ABHISHEK22415/f722-2020-fc/hardware/kicad/f722-2020-fc.kicad_sch

## KiCad design hardware/kicad/f722-2020-fc.kicad_sch (2026-10-28)

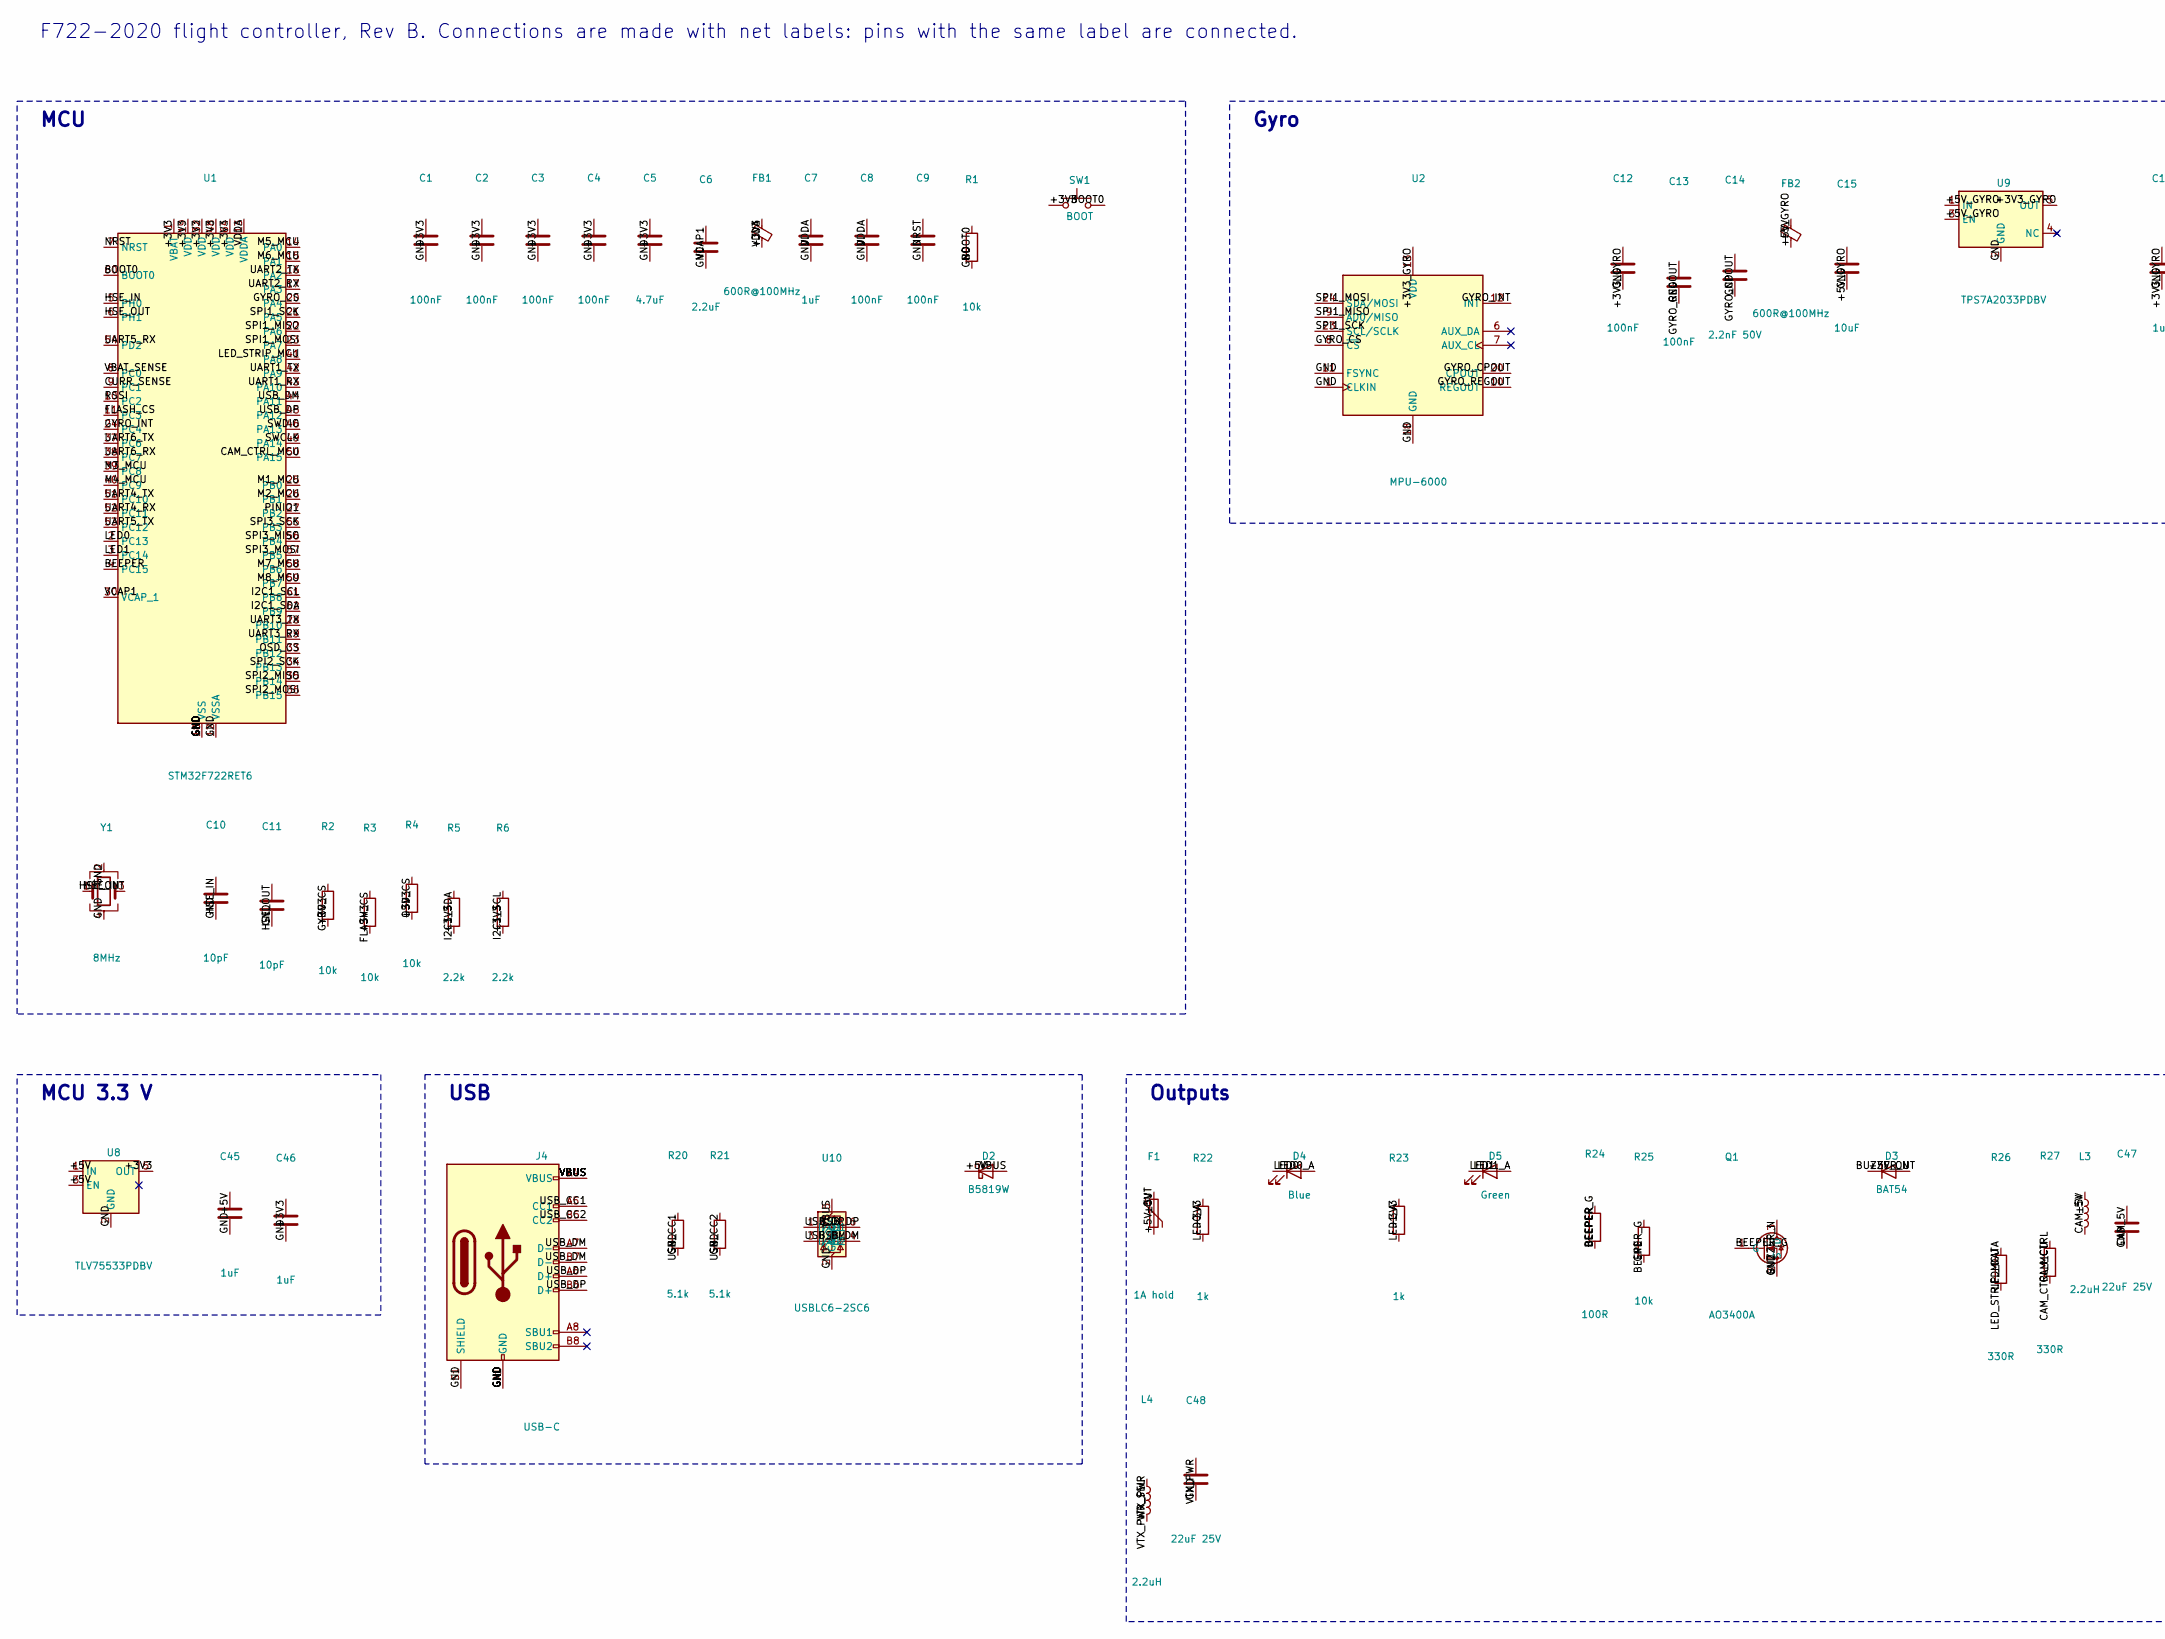
[picture p7: schematic f722-2020-fc.kicad_sch, part in row 1, column 1]

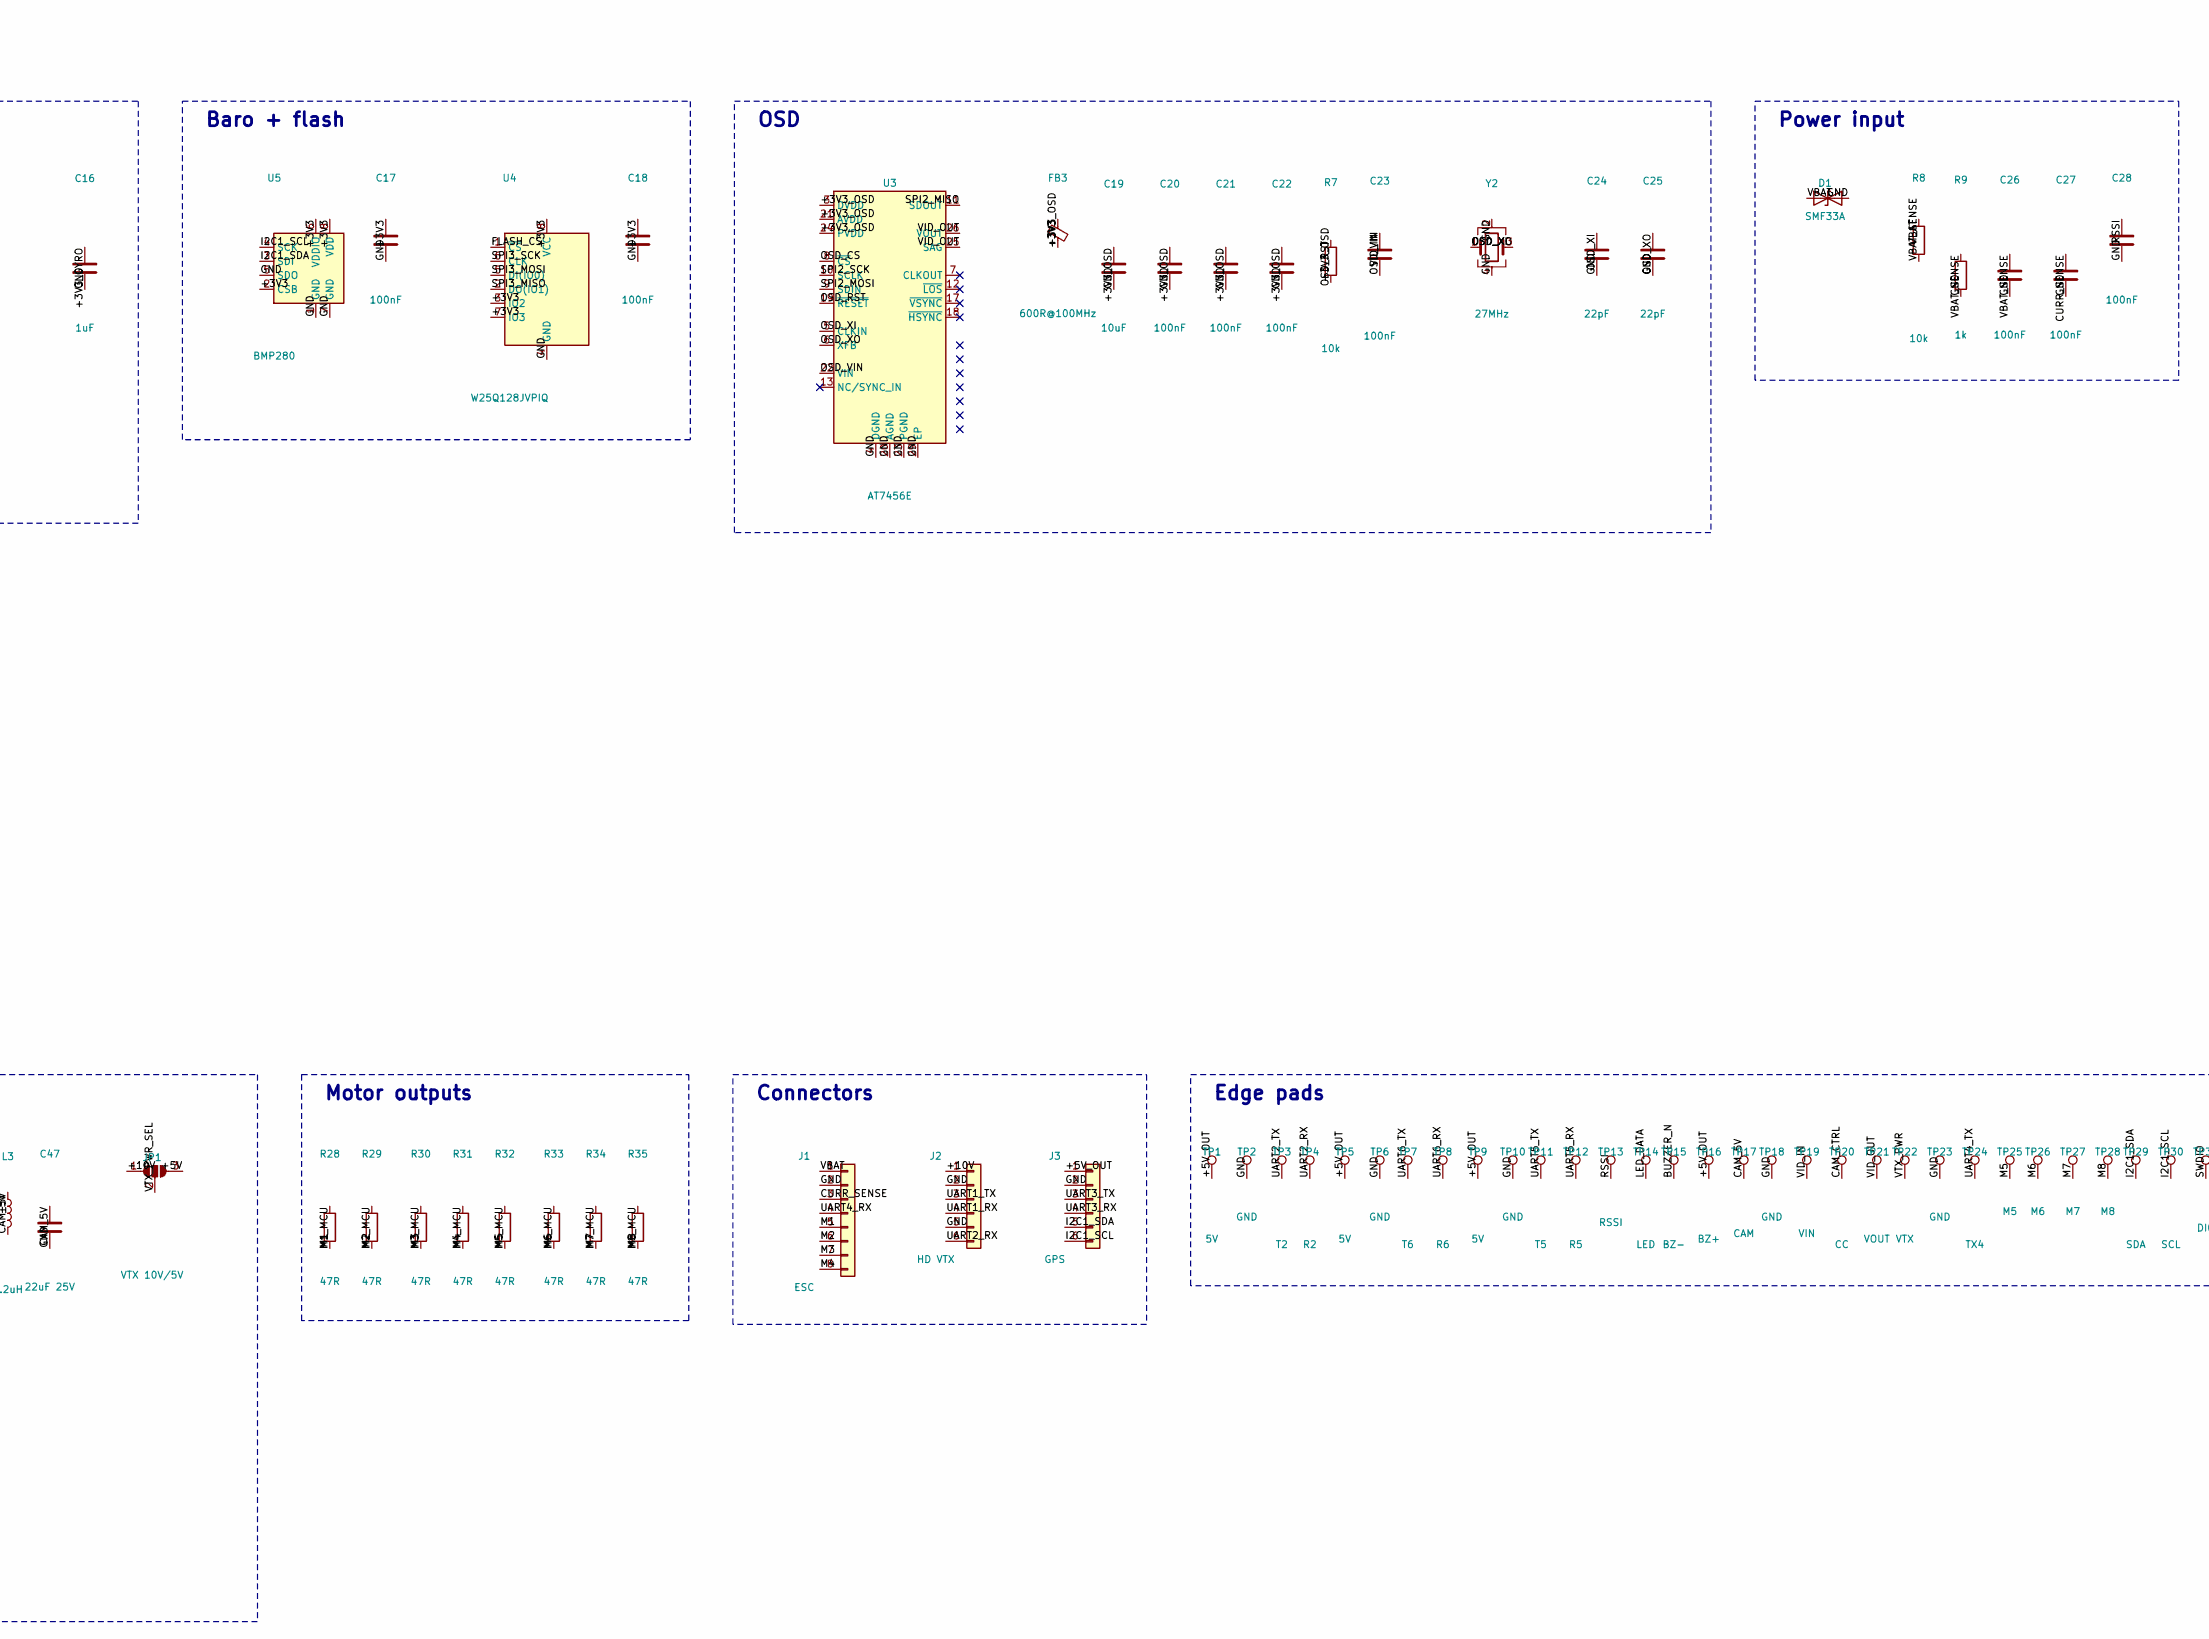
[picture p8: schematic f722-2020-fc.kicad_sch, part in row 1, column 2]

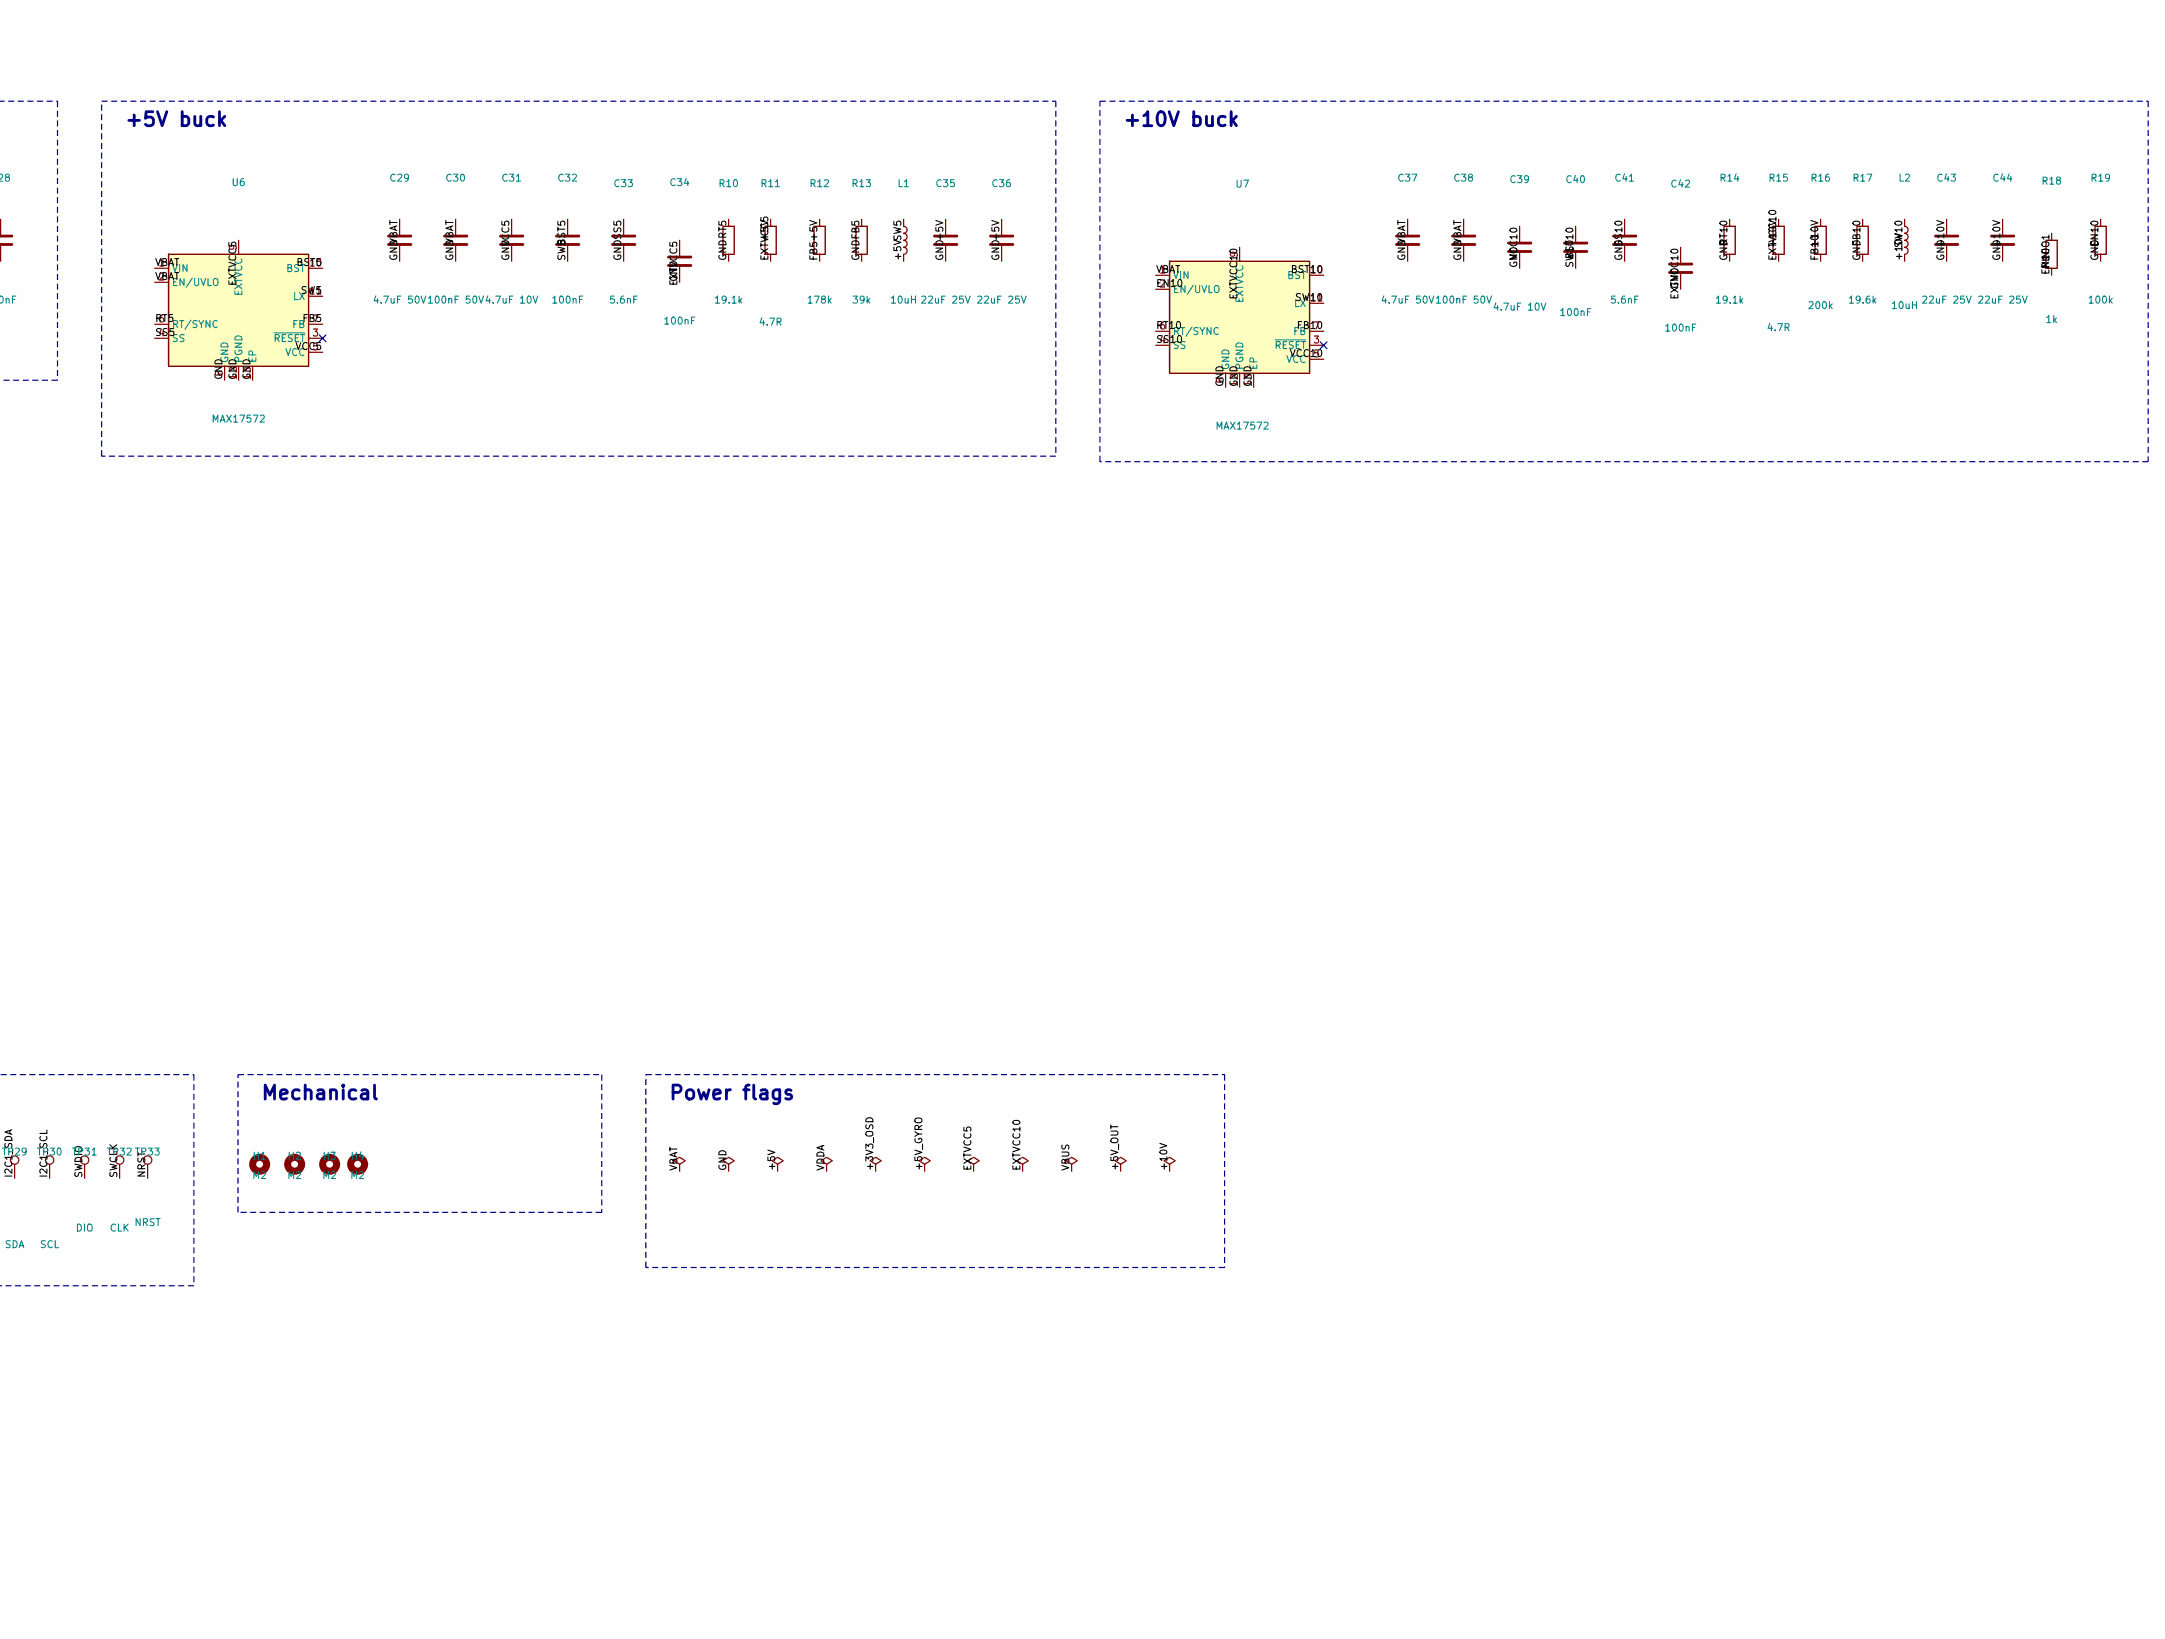
[picture p9: schematic f722-2020-fc.kicad_sch, part in row 1, column 3]

Parts:
C1, C2, C3, C4, C8, C9, C12, C13, C17, C18, C20, C21, C22, C23, C26, C27, C28, C32, C34, C40, C42: 100nF; C_0201_0603Metric
C5: 4.7uF; C_0603_1608Metric
C6: 2.2uF; C_0603_1608Metric
C7, C16, C45, C46: 1uF; C_0402_1005Metric
C10, C11: 10pF; C_0201_0603Metric
C14: 2.2nF 50V; C_0402_1005Metric
C15, C19: 10uF; C_0603_1608Metric
C24, C25: 22pF; C_0201_0603Metric
C29, C37: 4.7uF 50V; C_1206_3216Metric
C30, C38: 100nF 50V; C_0402_1005Metric
C31, C39: 4.7uF 10V; C_0603_1608Metric
C33, C41: 5.6nF; C_0201_0603Metric
C35, C36, C43, C44, C47, C48: 22uF 25V; C_0805_2012Metric
D1: SMF33A; D_SOD-123F
D2: B5819W; D_SOD-123
D3: BAT54; D_SOD-323
D4: Blue; LED_0603_1608Metric
D5: Green; LED_0603_1608Metric
F1: 1A hold; Fuse_1206_3216Metric
FB1, FB2, FB3: 600R@100MHz; L_0201_0603Metric
H1, H2, H3, H4: M2; MountingHole_2.2mm_M2
J1: ESC; JST_SH_BM08B-SRSS-TB_1x08-1MP_P1.00mm_Vertical
J2: HD VTX; JST_SH_BM06B-SRSS-TB_1x06-1MP_P1.00mm_Vertical
J3: GPS; JST_SH_BM06B-SRSS-TB_1x06-1MP_P1.00mm_Vertical
J4: USB-C; USB_C_Receptacle_HRO_TYPE-C-31-M-12
JP1: VTX 10V/5V; SolderJumper-3_P1.3mm_Open_RoundedPad1.0x1.5mm
L1, L2: 10uH; L_Taiyo-Yuden_MD-3030
L3, L4: 2.2uH; L_0805_2012Metric
Q1: AO3400A; SOT-23
R1, R2, R3, R4, R7, R25: 10k; R_0201_0603Metric
R5, R6: 2.2k; R_0201_0603Metric
R8: 10k; R_0402_1005Metric
R9, R18, R22, R23: 1k; R_0201_0603Metric
R10, R14: 19.1k; R_0201_0603Metric
R11, R15: 4.7R; R_0201_0603Metric
R12: 178k; R_0201_0603Metric
R13: 39k; R_0201_0603Metric
R16: 200k; R_0201_0603Metric
R17: 19.6k; R_0201_0603Metric
R19: 100k; R_0201_0603Metric
R20, R21: 5.1k; R_0201_0603Metric
R24: 100R; R_0201_0603Metric
R26, R27: 330R; R_0201_0603Metric
R28, R29, R30, R31, R32, R33, R34, R35: 47R; R_0201_0603Metric
SW1: BOOT; SW_SPST_B3U-1000P
TP1, TP5, TP9: 5V; TestPoint_Pad_1.5x1.5mm
TP2, TP6, TP10, TP18, TP23: GND; TestPoint_Pad_1.5x1.5mm
TP3: T2; TestPoint_Pad_1.5x1.5mm
TP4: R2; TestPoint_Pad_1.5x1.5mm
TP7: T6; TestPoint_Pad_1.5x1.5mm
TP8: R6; TestPoint_Pad_1.5x1.5mm
TP11: T5; TestPoint_Pad_1.5x1.5mm
TP12: R5; TestPoint_Pad_1.5x1.5mm
TP13: RSSI; TestPoint_Pad_1.5x1.5mm
TP14: LED; TestPoint_Pad_1.5x1.5mm
TP15: BZ-; TestPoint_Pad_1.5x1.5mm
TP16: BZ+; TestPoint_Pad_1.5x1.5mm
TP17: CAM; TestPoint_Pad_1.5x1.5mm
TP19: VIN; TestPoint_Pad_1.5x1.5mm
TP20: CC; TestPoint_Pad_1.5x1.5mm
TP21: VOUT; TestPoint_Pad_1.5x1.5mm
TP22: VTX; TestPoint_Pad_1.5x1.5mm
TP24: TX4; TestPoint_Pad_1.5x1.5mm
TP25: M5; TestPoint_Pad_1.5x1.5mm
TP26: M6; TestPoint_Pad_1.5x1.5mm
TP27: M7; TestPoint_Pad_1.5x1.5mm
TP28: M8; TestPoint_Pad_1.5x1.5mm
TP29: SDA; TestPoint_Pad_1.5x1.5mm
TP30: SCL; TestPoint_Pad_1.5x1.5mm
TP31: DIO; TestPoint_Pad_1.5x1.5mm
TP32: CLK; TestPoint_Pad_1.5x1.5mm
TP33: NRST; TestPoint_Pad_1.5x1.5mm
U1: STM32F722RET6; LQFP-64_10x10mm_P0.5mm
U2: MPU-6000; InvenSense_QFN-24_4x4mm_P0.5mm
U3: AT7456E; TSSOP-28-1EP_4.4x9.7mm_P0.65mm
U4: W25Q128JVPIQ; WSON-8-1EP_6x5mm_P1.27mm_EP3.4x4mm
U5: BMP280; Bosch_LGA-8_2x2.5mm_P0.65mm_ClockwisePinNumbering
U6, U7: MAX17572; DFN-12-1EP_3x3mm_P0.5mm_EP2.05x2.86mm
U8: TLV75533PDBV; SOT-23-5
U9: TPS7A2033PDBV; SOT-23-5
U10: USBLC6-2SC6; SOT-23-6
Y1: 8MHz; Crystal_SMD_3225-4Pin_3.2x2.5mm
Y2: 27MHz; Crystal_SMD_3225-4Pin_3.2x2.5mm

Connections:
+3V3: C1.1, C2.1, C3.1, C4.1, C5.1, C17.1, C18.1, C46.1, FB1.1, FB3.1, R2.2, R3.2, R4.2, R5.2, R6.2, R22.1, R23.1, SW1.1, U1.1 (VBAT), U1.19 (VDD), U1.32 (VDD), U1.48 (VDD), U1.64 (VDD), U4.3 (IO2), U4.7 (IO3), U4.8 (VCC), U5.2 (CSB), U5.6 (VDDIO), U5.8 (VDD), U8.5 (OUT)
+3V3_GYRO: C12.1, C16.1, U2.13 (VDD), U9.5 (OUT)
+3V3_OSD: C19.1, C20.1, C21.1, C22.1, FB3.2, R7.2, U3.3 (DVDD), U3.21 (AVDD), U3.24 (PVDD)
+5V: C35.1, C36.1, C45.1, D2.1 (K), F1.1, FB2.1, JP1.3 (B), L1.2, L3.1, R11.1, R12.1, U8.1 (IN), U8.3 (EN)
+5V_GYRO: C15.1, FB2.2, U9.1 (IN), U9.3 (EN)
+5V_OUT: D3.1 (K), F1.2, J3.1, TP1.1, TP5.1, TP9.1, TP16.1
+10V: C43.1, C44.1, J2.1, JP1.1 (A), L2.2, R15.1, R16.1
BEEPER: R24.1, U1.4 (PC15)
BEEPER_G: Q1.1 (G), R24.2, R25.1
BOOT0: R1.1, SW1.2, U1.60 (BOOT0)
BST5: C32.1, U6.10 (BST)
BST10: C40.1, U7.10 (BST)
BUZZER_N: D3.2 (A), Q1.3 (D), TP15.1
CAM_5V: C47.1, L3.2, TP17.1
CAM_CTRL: R27.2, TP20.1
CAM_CTRL_MCU: R27.1, U1.50 (PA15)
CURR_SENSE: C27.1, J1.3, U1.9 (PC1)
EN10: R18.2, R19.1, U7.2 (EN/UVLO)
EXTVCC5: C34.1, R11.2, U6.9 (EXTVCC)
EXTVCC10: C42.1, R15.2, U7.9 (EXTVCC)
FB5: R12.2, R13.1, U6.7 (FB)
FB10: R16.2, R17.1, U7.7 (FB)
FLASH_CS: R3.1, U1.11 (PC3), U4.1 (~CS)
GND: C1.2, C2.2, C3.2, C4.2, C5.2, C6.2, C7.2, C8.2, C9.2, C10.2, C11.2, C12.2, C13.2, C14.2, C15.2, C16.2, C17.2, C18.2, C19.2, C20.2, C21.2, C22.2, C24.2, C25.2, C26.2, C27.2, C28.2, C29.2, C30.2, C31.2, C33.2, C34.2, C35.2, C36.2, C37.2, C38.2, C39.2, C41.2, C42.2, C43.2, C44.2, C45.2, C46.2, C47.2, C48.2, D1.2 (A2), J1.2, J2.2, J2.5, J3.2, J4.A1 (GND), J4.A12 (GND), J4.B1 (GND), J4.B12 (GND), J4.S1 (SHIELD), Q1.2 (S), R1.2, R9.2, R10.2, R13.2, R14.2, R17.2, R19.2, R20.2, R21.2, R25.2, TP2.1, TP6.1, TP10.1, TP18.1, TP23.1, U1.12 (VSSA), U1.18 (VSS), U1.31 (VSS), U1.47 (VSS), U1.63 (VSS), U2.1 (CLKIN), U2.11 (FSYNC), U2.18 (GND), U3.4 (DGND), U3.20 (AGND), U3.23 (PGND), U3.29 (EP), U4.4 (GND), U5.1 (GND), U5.5 (SDO), U5.7 (GND), U6.8 (GND), U6.12 (PGND), U6.13 (EP), U7.8 (GND), U7.12 (PGND), U7.13 (EP), U8.2 (GND), U9.2 (GND), U10.2 (GND), Y1.2, Y1.4, Y2.2, Y2.4
GYRO_CPOUT: C14.1, U2.20 (CPOUT)
GYRO_CS: R2.1, U1.20 (PA4), U2.8 (~CS)
GYRO_INT: U1.24 (PC4), U2.12 (INT)
GYRO_REGOUT: C13.1, U2.10 (REGOUT)
HSE_IN: C10.1, U1.5 (PH0), Y1.1
HSE_OUT: C11.1, U1.6 (PH1), Y1.3
I2C1_SCL: J3.6, R6.1, TP30.1, U1.61 (PB8), U5.4 (SCK)
I2C1_SDA: J3.5, R5.1, TP29.1, U1.62 (PB9), U5.3 (SDI)
LED0: D4.1 (K), U1.2 (PC13)
LED0_A: D4.2 (A), R22.2
LED1: D5.1 (K), U1.3 (PC14)
LED1_A: D5.2 (A), R23.2
LED_DATA: R26.2, TP14.1
LED_STRIP_MCU: R26.1, U1.41 (PA8)
M1: J1.5, R28.2
M1_MCU: R28.1, U1.25 (PB0)
M2: J1.6, R29.2
M2_MCU: R29.1, U1.26 (PB1)
M3: J1.7, R30.2
M3_MCU: R30.1, U1.39 (PC8)
M4: J1.8, R31.2
M4_MCU: R31.1, U1.40 (PC9)
M5: R32.2, TP25.1
M5_MCU: R32.1, U1.14 (PA0)
M6: R33.2, TP26.1
M6_MCU: R33.1, U1.15 (PA1)
M7: R34.2, TP27.1
M7_MCU: R34.1, U1.58 (PB6)
M8: R35.2, TP28.1
M8_MCU: R35.1, U1.59 (PB7)
NRST: C9.1, TP33.1, U1.7 (NRST)
OSD_CS: R4.1, U1.33 (PB12), U3.8 (~CS)
OSD_RST: R7.1, U3.19 (~RESET)
OSD_VIN: C23.2, U3.22 (VIN)
OSD_XI: C24.1, U3.5 (CLKIN), Y2.1
OSD_XO: C25.1, U3.6 (XFB), Y2.3
PINIO1: R18.1, U1.27 (PB2)
RSSI: C28.1, TP13.1, U1.10 (PC2)
RT5: R10.1, U6.6 (RT/SYNC)
RT10: R14.1, U7.6 (RT/SYNC)
SPI1_MISO: U1.22 (PA6), U2.9 (AD0/MISO)
SPI1_MOSI: U1.23 (PA7), U2.24 (SDA/MOSI)
SPI1_SCK: U1.21 (PA5), U2.23 (SCL/SCLK)
SPI2_MISO: U1.35 (PB14), U3.11 (SDOUT)
SPI2_MOSI: U1.36 (PB15), U3.9 (SDIN)
SPI2_SCK: U1.34 (PB13), U3.10 (SCLK)
SPI3_MISO: U1.56 (PB4), U4.2 (DO(IO1))
SPI3_MOSI: U1.57 (PB5), U4.5 (DI(IO0))
SPI3_SCK: U1.55 (PB3), U4.6 (CLK)
SS5: C33.1, U6.4 (SS)
SS10: C41.1, U7.4 (SS)
SW5: C32.2, L1.1, U6.11 (LX)
SW10: C40.2, L2.1, U7.11 (LX)
SWCLK: TP32.1, U1.49 (PA14)
SWDIO: TP31.1, U1.46 (PA13)
UART1_RX: J2.4, U1.43 (PA10)
UART1_TX: J2.3, U1.42 (PA9)
UART2_RX: J2.6, TP4.1, U1.17 (PA3)
UART2_TX: TP3.1, U1.16 (PA2)
UART3_RX: J3.4, U1.29 (PB11)
UART3_TX: J3.3, U1.28 (PB10)
UART4_RX: J1.4, U1.52 (PC11)
UART4_TX: TP24.1, U1.51 (PC10)
UART5_RX: TP12.1, U1.54 (PD2)
UART5_TX: TP11.1, U1.53 (PC12)
UART6_RX: TP8.1, U1.38 (PC7)
UART6_TX: TP7.1, U1.37 (PC6)
USB_CC1: J4.A5 (CC1), R20.1
USB_CC2: J4.B5 (CC2), R21.1
USB_DM: J4.A7 (D-), J4.B7 (D-), U1.44 (PA11), U10.3 (I/O2), U10.4 (I/O2)
USB_DP: J4.A6 (D+), J4.B6 (D+), U1.45 (PA12), U10.1 (I/O1), U10.6 (I/O1)
VBAT: C29.1, C30.1, C37.1, C38.1, D1.1 (A1), J1.1, R8.1, U6.1 (VIN), U6.2 (EN/UVLO), U7.1 (VIN)
VBAT_SENSE: C26.1, R8.2, R9.1, U1.8 (PC0)
VBUS: D2.2 (A), J4.A4 (VBUS), J4.A9 (VBUS), J4.B4 (VBUS), J4.B9 (VBUS), U10.5 (VBUS)
VCAP1: C6.1, U1.30 (VCAP_1)
VCC5: C31.1, U6.5 (VCC)
VCC10: C39.1, U7.5 (VCC)
VDDA: C7.1, C8.1, FB1.2, U1.13 (VDDA)
VID_IN: C23.1, TP19.1
VID_OUT: TP21.1, U3.25 (SAG), U3.26 (VOUT)
VTX_PWR: C48.1, L4.2, TP22.1
VTX_PWR_SEL: JP1.2 (C), L4.1

Notes on the sheet:
MCU
Gyro
Baro + flash
OSD
Power input
+5V buck
+10V buck
MCU 3.3 V
USB
Outputs
Motor outputs
Connectors
Edge pads
Mechanical
Power flags
F722-2020 flight controller, Rev B. Connections are made with net labels: pins with the same label are connected.
