ABHISHEK22415/f722-2020-fc/(commit log)

2026-10-27 Add F722-2020 flight controller design (Rev A)
    Design spec, noise and EMI review, pin map, BOM, Betaflight starting
    config and interactive 3D viewer for a 20x20 STM32F722 + MPU6000 FC.
    [bom.csv, pinout.csv]
2026-10-27 Add 3D renders, traces view and live viewer link to README
    Viewer: Traces toggle with colour-coded signal routing on both sides,
    port focus dims unrelated traces, corrected colours and flip axis.
    README: renders of parts, top and bottom traces, and the port locator.
2026-10-28 Add Rev B KiCad schematic (Altium-importable) with noise-review fixes
    [f722-2020-fc.kicad_sch]
